TobleMiner/vfd-breadboard-adapter/noritake_mn12864k_vfd_breakout.kicad_pcb

## KiCad design noritake_mn12864k_vfd_breakout.kicad_pcb (2020-09-10)

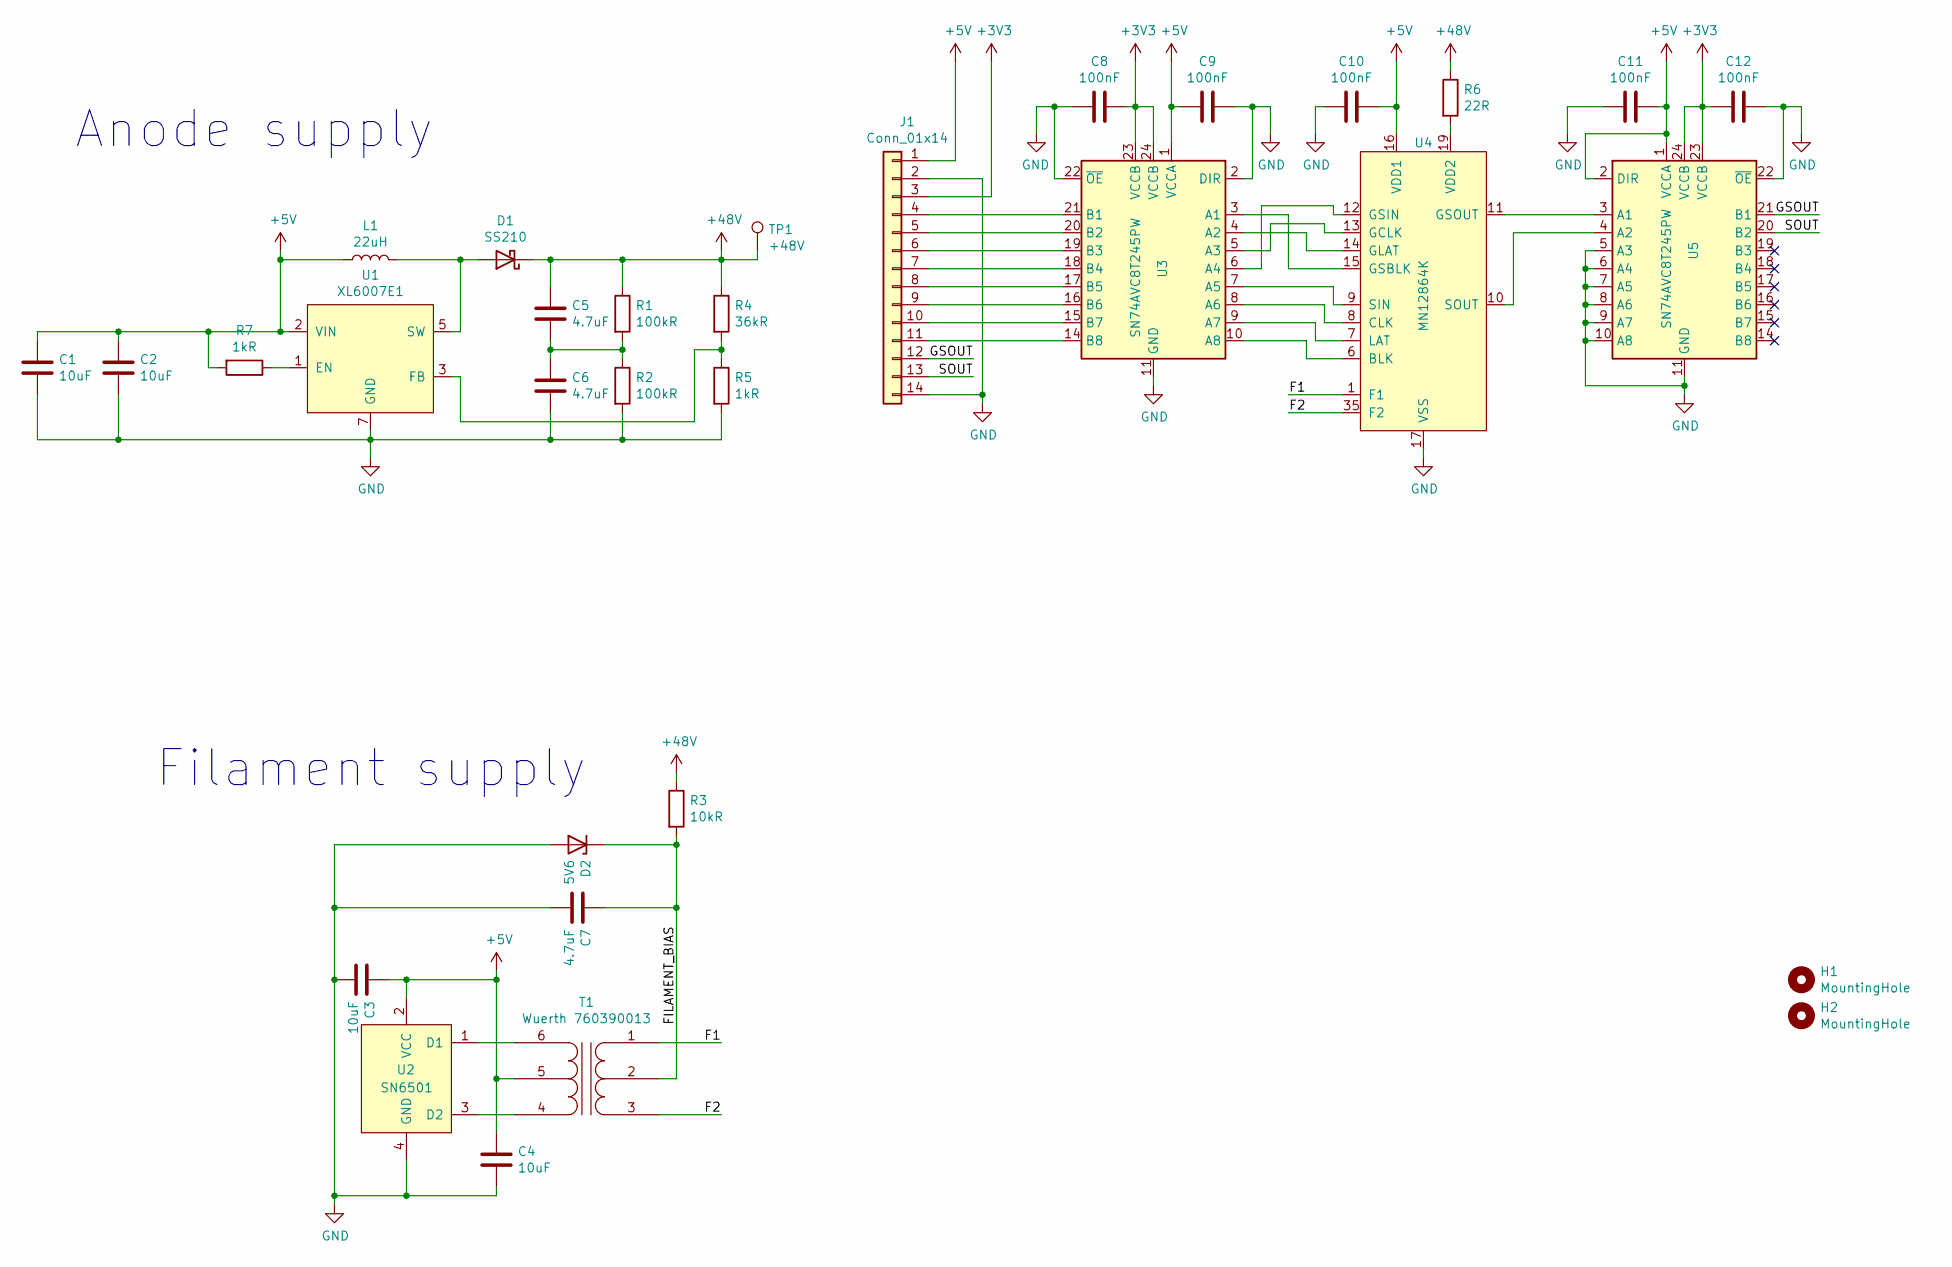
[picture p1: schematic noritake_mn12864k_vfd_breakout.sch]

Parts:
C1, C2, C3: 10uF; C_0805_2012Metric; LCSC C15850
C4: 10uF; C_1206_3216Metric; LCSC C13585
C5, C6, C7: 4.7uF; C_1206_3216Metric; LCSC C29823
C8, C9, C10, C11, C12: 100nF; C_0402_1005Metric; LCSC C1525
D1: SS210; D_SMA; LCSC C14996
D2: 5V6; D_MiniMELF; LCSC C8062
H1, H2: MountingHole; ToolingHole_JLCSMT
J1: Conn_01x14; PinHeader_1x14_P2.54mm_Vertical
L1: 22uH; MWSA0503S; LCSC C408340
R1, R2: 100kR; R_0805_2012Metric; LCSC C17407
R3: 10kR; R_1206_3216Metric; LCSC C17902
R4: 36kR; R_0805_2012Metric; LCSC C4360
R5, R7: 1kR; R_0402_1005Metric; LCSC C25905
R6: 22R; R_1206_3216Metric; LCSC C17958
T1: Wuerth 760390013; Transformer_Würth_10.05x6.73_6P
TP1: +48V; TestPoint_Pad_2.0x2.0mm
U1: XL6007E1; SO-8_3.9x4.9mm_P1.27mm; LCSC C73334
U2: SN6501; SOT-23-5
U3, U5: SN74AVC8T245PW; TSSOP-24_4.4x7.8mm_P0.65mm; LCSC C7859
U4: MN12864K

Connections:
+3V3: C8.1, C12.1, J1.3, U3.23 (VCCB), U3.24 (VCCB), U5.23 (VCCB), U5.24 (VCCB)
+5V: C1.1, C2.1, C3.1, C4.2, C9.2, C10.1, C11.2, J1.1, L1.1, R7.2, T1.5, U1.2 (VIN), U2.2 (VCC), U3.1 (VCCA), U4.16 (VDD1), U5.1 (VCCA), U5.2 (DIR)
+48V: C5.1, D1.1 (K), R1.1, R3.1, R4.1, R6.1, TP1.1
/F1: T1.1, U4.1 (F1), U4.2 (F1), U4.3 (F1)
/F2: T1.3, U4.35 (F2), U4.36 (F1), U4.37 (F1)
/FILAMENT_BIAS: C7.1, D2.1 (K), R3.2, T1.2
/GSOUT: J1.12, U5.21 (B1)
/SOUT: J1.13, U5.20 (B2)
GND: C1.2, C2.2, C3.2, C4.1, C6.2, C7.2, C8.2, C9.1, C10.2, C11.1, C12.2, D2.2 (A), J1.2, J1.14, R2.2, R5.2, U1.7 (GND), U1.8 (GND), U2.4 (GND), U2.5 (GND), U3.2 (DIR), U3.11 (GND), U3.12 (GND), U3.13 (GND), U3.22 (~OE), U4.17 (VSS), U4.18 (VSS), U5.5 (A3), U5.6 (A4), U5.7 (A5), U5.8 (A6), U5.9 (A7), U5.10 (A8), U5.11 (GND), U5.12 (GND), U5.13 (GND), U5.22 (~OE)
unnamed: C5.2, C6.1, R1.2, R2.1
unnamed: D1.2 (A), L1.2, U1.5 (SW), U1.6 (SW)
unnamed: J1.4, U3.21 (B1)
unnamed: J1.5, U3.20 (B2)
unnamed: J1.6, U3.19 (B3)
unnamed: J1.7, U3.18 (B4)
unnamed: J1.8, U3.17 (B5)
unnamed: J1.9, U3.16 (B6)
unnamed: J1.10, U3.15 (B7)
unnamed: J1.11, U3.14 (B8)
unnamed: R4.2, R5.1, U1.3 (FB)
unnamed: R7.1, U1.1 (EN)
unnamed: T1.4, U2.3 (D2)
unnamed: T1.6, U2.1 (D1)
unnamed: U3.3 (A1), U4.15 (GSBLK)
unnamed: U3.4 (A2), U4.14 (GLAT)
unnamed: U3.5 (A3), U4.13 (GCLK)
unnamed: U3.6 (A4), U4.12 (GSIN)
unnamed: U3.7 (A5), U4.9 (SIN)
unnamed: U3.8 (A6), U4.8 (CLK)
unnamed: U3.9 (A7), U4.7 (LAT)
unnamed: U3.10 (A8), U4.6 (BLK)
unnamed: U4.10 (SOUT), U5.4 (A2)
unnamed: U4.11 (GSOUT), U5.3 (A1)
VDD2: R6.2, U4.19 (VDD2), U4.20 (VDD2)

Notes on the sheet:
Filament supply
Anode supply

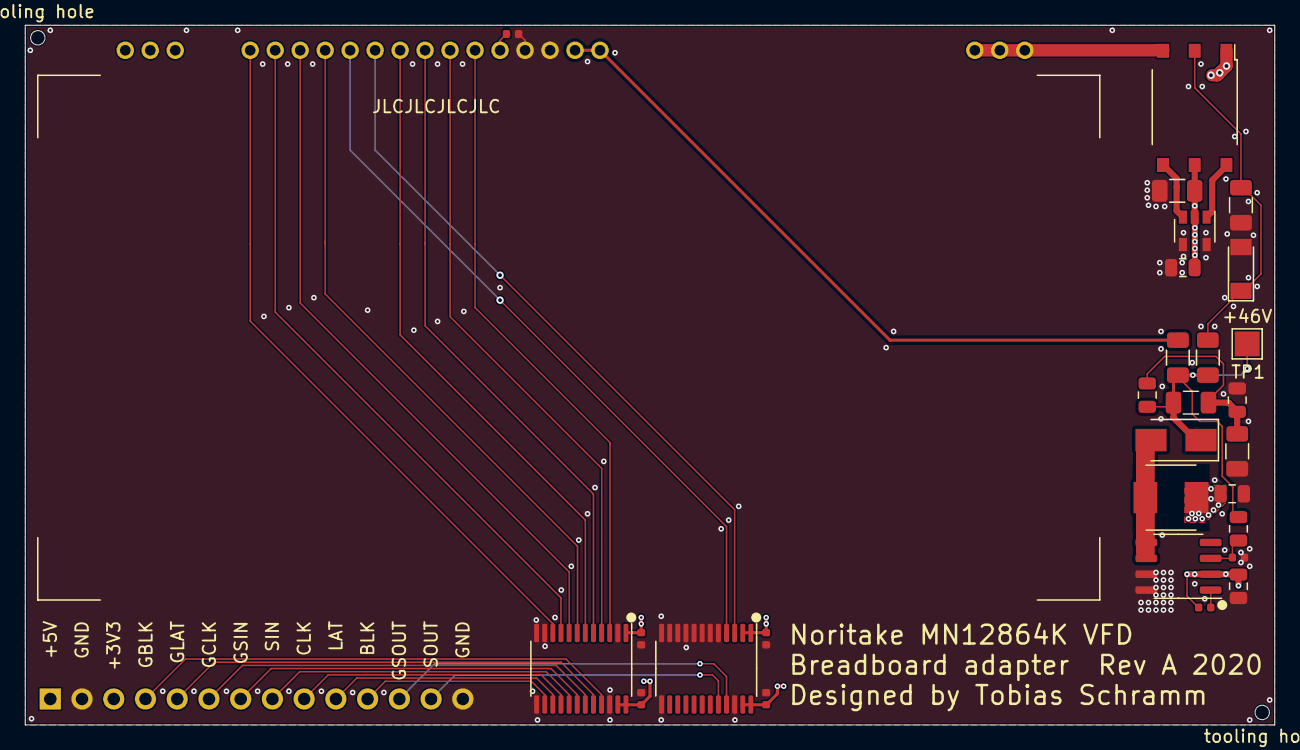
[picture p2: board noritake_mn12864k_vfd_breakout.kicad_pcb from above]

Board: 4 copper layers, 100.0 x 56.0 mm, 32 parts (1 on the bottom side), 34 nets.
