TobleMiner/vfd-breadboard-adapter/(commit log)

2020-09-10 Finish layout for assembly
    [noritake_mn12864k_vfd_breakout.kicad_pcb, noritake_mn12864k_vfd_breakout.sch]
2020-09-30 Fix 1kR LCSC partnumber
    [noritake_mn12864k_vfd_breakout.sch]
